nicshackle/FreediveWatch/images/backView.jpeg

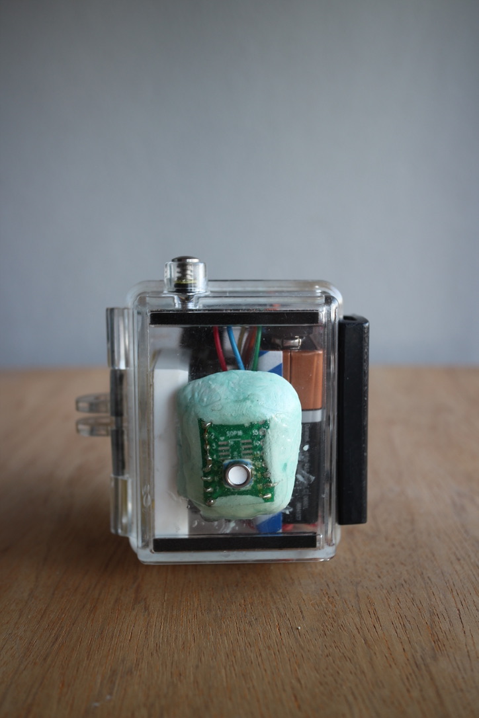
images/backView.jpeg
